jdalrym2/synscancontrol/(list of files, cad)

Other CAD files:
docs/PCB_Synscan-Control-Rev-3_2024-09-07.dxf
