jdalrym2/synscancontrol/src/synscancontrol/Constants.hpp

/*
 * Project Name: synscancontrol
 * File: Constants.hpp
 *
 * Copyright (C) 2024 Jon Dalrymple
 *
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
 * Author: Jon Dalrymple
 * Created: 13 November 2024
 * Description: Constant and configurable parameters
 */
#ifndef CONSTANTS_H
#define CONSTANTS_H

#include <stdint.h>

namespace SynScanControl
{

    /* Arcsecond -> degree multiplier (i.e. 1/60/60) */
    constexpr float ARCSEC_TO_DEGREE = 2.77778E-4;

    /* Sidereal speed in arcseconds / second */
    constexpr float SIDEREAL_SPEED_ARCSEC = 15.04108444;

    /* Buffer size for serial commands
     * 256 is plenty for the Synscan serial interface,
     * but this can be increased to support longer commands
     * at the expense of available memory.
     */
    constexpr uint32_t COMMAND_BUFFER_SIZE = 256;

    /* Stepper driver pulse width in microseconds
     *
     * The minimum pulse width for the DRV8825 per
     * spec is 1.9us, so this must be larger than that,
     * ideally a few times larger.
     */
    constexpr uint16_t STEPPER_PULSE_WIDTH_US = 4;

#ifdef SERIAL_TIMEOUT
    /* Halt the motors if we don't get any serial
     * commands in this amount of milliseconds.
     *
     * This requires the connected device to be at
     * least querying the status of the mount faster
     * than this interval.
     */
    constexpr uint32_t SERIAL_TIMEOUT_MS = 3000;
#endif

    /* Motor microstepping parameters
     * We will alternate between slow / fast microstepping
     * depending on state. A high number of microsteps
     * implies more discrete pulses per revolution
     */
    constexpr uint32_t SLOW_MICROSTEPS = 32;
    constexpr uint32_t FAST_MICROSTEPS = 8;
    constexpr uint32_t HIGH_SPEED_RATIO = SLOW_MICROSTEPS / FAST_MICROSTEPS;

    /* Number of steps per full revolution of the mount's axis. */
    constexpr uint32_t FULL_STEPS_PER_REV = 141000;
    constexpr uint32_t MICROSTEPS_PER_REV = SLOW_MICROSTEPS * FULL_STEPS_PER_REV;
    constexpr float SIDEREAL_STEP_PER_SECOND = (float)MICROSTEPS_PER_REV / 360.0 * ARCSEC_TO_DEGREE * SIDEREAL_SPEED_ARCSEC;

    /* Maximum number of pulses per second we feel comfortable driving the motor.
     * Increasing this would slew the mount faster at the cost of stability.
     */
    constexpr uint32_t MAX_PULSE_PER_SECOND = 20000;
    constexpr float SIDEREAL_PULSE_PER_STEP = MAX_PULSE_PER_SECOND / SIDEREAL_STEP_PER_SECOND;

    /* How fast to accelerate the motors, in pulses / sec / sec.
     * Increasing this would get the motors up to speed faster
     * at the cost of stability.
     */
    constexpr float MOTOR_ACCEL = 5000.0;

    /* Polar scope PWM frequency in Hz */
    constexpr uint32_t POLARSCOPE_PWM_FREQ = 5000;

    /* Starting brightness of the polar scope LED */
    constexpr uint8_t POLARSCOPE_INIT_BRIGHTNESS = 16;

    /* RA motor pinouts to DRV8825 */
    constexpr uint8_t RA_M0 = 12;
    constexpr uint8_t RA_M1 = 14;
    constexpr uint8_t RA_M2 = 27;
    constexpr uint8_t RA_STEP = 26;
    constexpr uint8_t RA_DIR = 25;

    /* RA motor pinouts to DRV8825 */
    constexpr uint8_t DEC_M0 = 33;
    constexpr uint8_t DEC_M1 = 32;
    constexpr uint8_t DEC_M2 = 5;
    constexpr uint8_t DEC_STEP = 18;
    constexpr uint8_t DEC_DIR = 19;

    /* Autoguider port input pins */
    constexpr uint8_t RA_POS_PIN = 36;
    constexpr uint8_t DEC_POS_PIN = 39;
    constexpr uint8_t RA_NEG_PIN = 34;
    constexpr uint8_t DEC_NEG_PIN = 35;

    /* LED controller pins */
    constexpr uint8_t PWR_LED = 4;
    constexpr uint8_t SCOPE_LED = 15;
    constexpr uint8_t BUILT_IN_LED = 2;

    /* LED PWM channels */
    constexpr uint8_t PWR_LED_PWM = 0;
    constexpr uint8_t SCOPE_LED_PWM = 1;
    constexpr uint8_t BUILT_IN_LED_PWM = 2;

    /* Serial pinouts and UART numbers */
    constexpr uint8_t SERIAL_LOGGER_UART = 0;
    constexpr uint8_t SERIAL_SYNSCAN_UART = 1;
    constexpr uint8_t SERIAL_SYNSCAN_RX = 16;
    constexpr uint8_t SERIAL_SYNSCAN_TX = 17;

#if defined(OTA_UPDATES) || defined(UDP_LOGGING)
    /* WiFI SSID / password (if applicable) */
    const char WIFI_SSID[] = "YOUR_SSID_HERE";
    const char WIFI_PASSWORD[] = "YOUR_PASSWORD_HERE";
#endif

#ifdef UDP_LOGGING
    /* Port used for UDP logging (if applicable) */
    constexpr uint16_t UDP_LOGGER_PORT = 6309;
#endif

}

#endif /* CONSTANTS_H */
