jdalrym2/synscancontrol/(commit log)

2021-08-29 All input commands can now be parsed. Several motor-related commands are now handled.
2021-09-12 More development, basic motor control, all commands parsed.
2021-09-12 Compiles on ESP32 now!!
2021-11-08 Added serial timeout feature (stops the motors after 5 sec no comms). Cleanup. Adjustment to avoid steppers stalling.
    [CommandHandler.cpp, CommandHandler.hpp, Motor.cpp, Motor.hpp, main.cpp]
2021-11-08 Cleanup. Static LED brightness for now.
2022-01-04 - Added build flag for whether or not to implement serial timeout. - Edited code such that DEC axis starts at +90.0 (parking position) - Made sure motors moved as fast as possible in GOTO mode. - Spe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
2022-01-06 Added support for setting the brightness of the polar scope LED. Started work getting rid of tracking the stepper motor position.
2022-01-19 Changed code to no longer be dependent on AccelStepper.
    [InterruptStepper.cpp, InterruptStepper.hpp, Motor.cpp, Motor.hpp, main.cpp]
2024-11-17 Add photos and PCB schematic
2024-11-20 Fixed pretty funny typo
    [Command.cpp, Command.hpp, CommandHandler.cpp]
2024-11-23 Made it more obvious that this is an ESP32-based project
2024-11-23 Add remaining PCB files
    [PCB_Synscan-Control-Rev-3_2024-09-07.dxf]
2024-11-24 Add blinking status LED, WiFi logic
2024-11-24 Pin older version of espressif32
